glazet/QuadEVCharger/Schematics/S3pinout.pdf

Pin Name | Pin # | Used For | Pin Name | Pin # | Used For | PILOT_IN | ADC Pilot Read
1 | 4 | SW_IN (A) | 4 | 26 | PILOT_IN (C) | CT_IN | Current Transformer ADC Input
2 | 5 | SW_IN (B) | 5 | 27 | PILOT_IN (D) | PWM | PWM Generation Pin
42 | 6 | RL_OUT (A) | 6 | 28 | PILOT_IN (A) | RL_OUT | Relay Driver Pin
41 | 7 | RL_OUT (B) | 7 | 29 | PILOT_IN (B) | SW_IN | Switch Input
40 | 8 | RL_OUT (C) | 15 | 30 | CT_IN (A)
39 | 9 | RL_OUT (D) | 16 | 31 | CT_IN (B)
38 | 10 | NFC_MOSI | 17 | 32 | CT_IN (C)
37 | 11 | LCD_SDI | 18 | 33 | CT_IN (D)
36 | 12 | NFC_SCK | 8 | 34 | LCD_CS
35 | 13 | LCD_DC | 3 | 35
0 | 14 | GLED_OUT | 46 | 36 | PWM_C
45 | 15 | RLED_OUT | 9 | 37 | PWM_D
34 | 16 | PWM_B | 10 | 38 | NFC_SS
33 | 17 | PWM_A | 11 | 39 | LCD_RST
21 | 18 | | 12 | 40 | LCD_SCK
20 | 19 | SW_IN (C) | 13 | 41 | NFC_MISO
19 | 20 | SW_IN (D) | 14 | 42 | NFC_RST
