glazet/QuadEVCharger/(threads)

Thread 4 (2023-09-17):

Simple Product Description

neilh10, 2023-09-17:
Issue can be used as tracking items. I'm generating a few here to be tracked and discussed

What is a simple product description?. In keeping it simple, the exact words may be re-defined as there is more understanding of the potential customers

CalvinJDP, 2023-09-17:
Our team, Kilowatt Kings, is currently working on the design of a Smart Quad Electric Vehicle Charger. We have three primary objectives we aim to address. Our first objective is to address the new 2023 CalGreen requirement, which mandates one EV charger per four parking spaces. Our second objective is to efficiently provide charging for a 1:4 ratio of cars per charging station. Out third objective is to ensure that each car receives a charge sufficient for an estimated 30-mile commute, considering the average commute distance in California. Our approach to achieve these objectives involves designing a single-unit EV charger capable of accommodating four cars simultaneously. Each car will receive approximately 30 minutes of charge time before the system cycles to the next vehicle.

glazet, 2023-09-18:
An even more simple version:
Our team, the Kilowatt Kings, are designing an EV charger that can charge up to four vehicles from a single charging station and will meet upcoming CALGreen regulations. The charger will provide enough charge to the vehicle to make a 30-mile commute. When multiple vehicles are plugged in, the station will decide which vehicle gets charge and for how long.

Closed 2024-04-14.

Thread 5 (2023-09-17):

Who are Potential Customers

neilh10, 2023-09-17:
Issue can be used as tracking items. I'm generating a few here to be tracked and discussed

Neil:  Who are the potential customers - the people who specify it and/or buy it.

From Bab Solater's email 2023-09-16,
4.	Develop some understanding as to who may be potential customers and
the business models that are likely to be deployed, e.g.:

a.	End customers: Property owners/developers/property managers
b.	“Intermediate customers” eg. Design/Build Contractors

CalvinJDP, 2023-09-17:
Our potential customers would be property developers/contractors, property owners, businesses with parking facilities, and EV fleet owners.

glazet, 2023-09-17:
Also EV charger manufacturers could want a quad charger. I have only found dual chargers being sold. I'm not sure if EV manufacturers would be interested in a charger that isn't their proprietary model. After reading an NPR article on EV charger demand, city municipalities could want these chargers to install on the streets.

neilh10, 2023-09-18:
@CalvinJDP  good, needs maybe more flushing out.  At the core - potential customer are those who have 4 parking spaces that a consumer vehicle might plug into and be left for 4+ hours.  So multi-family overnight, workplace parking lots for daytime parking, Ferry Terminal parking, commuter park and ride, Then its the process who designs for these spaces and who owns them.

neilh10, 2023-09-18:
> Also EV charger manufacturers could want a quad charger. I have only found dual chargers being sold. I'm not sure if EV manufacturers would be interested in a charger that isn't their proprietary model. After reading an NPR article on EV charger demand, city municipalities could want these chargers to install on the streets.

@glazet  I think should track all the EV chargers you find https://github.com/glazet/QuadEVCharger/issues/9

Closed 2023-11-07.

Thread 6 (2023-09-18):

What questions should be asked of potential customers while researching Quad EV Chargee

neilh10, 2023-09-18:
Neil email : 3) and then what questions for potential customers when you meet with them.
Focused question on the potential customer pain more appropriate than the
engineering of tell us your specification for our product.

Bob Salter email : 5.      In my opinion your interview questions should be focused on
discovering pain points/wants/needs. The questions will likely be different
for each type of customer that you interview.

@glazet provided a brain storming first pass - can you filter them through the above lens and post here.

CalvinJDP, 2023-09-18:
We have revisited the interview questions, I have posted them below. We are actively adding questions as we learn more about EV chargers.

 1) Are you familiar with the new upcoming CalGreen requirements for EV chargers?
 2) When designing EVSE, do you have any environmental concerns such as
     weatherproofing or site development?
 3) What are your concerns, if any, about electrical infrastructure in a given complex?
 4) *Site Owner* Do you currently have the electrical infrastructure to install EV chargers?
5) How do you envision scaling up/adding EV charging infrastructure to accommodate the growth of EVs?
 6) What challenges do you encounter during peak charging hours?
 7) Have you experienced any issues or challenges with existing EV chargers that you would like addressed in a new design?
 8) What is your preferred charging station/charging connector type?
 9) Are you open to providing feedback during the charger development process?
10) What do you consider crucial to ensure that EV charging stations are accessible for residents and customers?
11) How much space do you typically have to integrate new EV charging stations? Do you have a lot of space to work with or not a lot?
12) *If they do not have EV charging stations*Are you considering whether to make your EV charging stations available to the public or restrict their use solely to your tenants?
13) Given the potential cost of upgrading and installing these stations, are you planning to offer usage for free, include their usage cost within the rent, or charge users directly for their use?

Closed 2023-11-07.

Thread 7 (2023-09-18):

What specifications

neilh10, 2023-09-18:
What specifications does an EV Charger need to meet.  Provide a link or reference to the specification - this is likely to become a marketing specification.

djangodemetri, 2023-09-21:
[NEC 625 (Page 25)](https://www.nrel.gov/docs/fy21osti/78085.pdf) specifies installation of EVSE,
     Circuit breakers sized for 125% of load (which would be 50A for us)
     8AWG for cable
     Length less than 25 feet
     No back-feeding from EV when grid loses power

[ISO 15118's Plug and Charge](https://en.wikipedia.org/wiki/ISO_15118) controls identification and authentication over IP

[IEC 61851-1](https://webstore.iec.ch/publication/33644) defines duty cycle values Control Pilot (CP)

[Open Charge Point Interface (OCPI)](https://www.ampcontrol.io/post/what-is-ocpi-and-why-is-it-important-for-ev-operators) allows cross company payment/charging

[Open Charge Point Protocol (OCPP)](https://en.wikipedia.org/wiki/Open_Charge_Point_Protocol) is protocol between EVSE and network

[IEC Mode 3](https://www.allaboutcircuits.com/technical-articles/four-ev-charging-modes-iec61851-standard/) means permanent cord set

[IC-CPD](https://www.aptiv.com/docs/default-source/user-manual/english-user-manual-ic-cpd.pdf?sfvrsn=acac163e_2) provides additional circuit breaker and ground monitoring

[NEMA 14-50R](https://calgreenenergyservices.com/2022/08/24/2022-calgreen-tier-1-and-2-ev-requirements/) is receptacle for EVSE

[HOA and EVSE Interactions](https://california.public.law/codes/ca_civ_code_section_4745)

Closed 2024-04-14.

Thread 8 (2023-09-18):

What functionality does the common control need to support

neilh10, 2023-09-18:
This is a tracking item to collect the internal engineering technical requirements for the common control.
This may map to items specified in https://github.com/glazet/QuadEVCharger/issues/7

For instance each charging port has technical specifications to detect a charging cable plugged in, and also through a 12V 1KHz PWM. Provide a technical reference for each specification

This is likely to feed into the decision on what small board computer to use, and inputs and outputs it needs to support, with custom hardware needed

glazet, 2023-09-21:
I have been looking into what microcontrollers we can use to output 4 PWM signals.  I have found a few:

ESP32 - Has 16 channels for configurable PWM signals. See page 36. ESP has a large community so resources should be manageable to find. Currently using ESP8266 in my IoT class, will soon develop comfortability with this chip.
chrome-extension://efaidnbmnnnibpcajpcglclefindmkaj/https://www.espressif.com/sites/default/files/documentation/esp32_datasheet_en.pdf

Arduino Mega 2560 Rev3 - This has 15 pins that can be used as a PWM channel. Its Arduino so heavy support as well.
chrome-extension://efaidnbmnnnibpcajpcglclefindmkaj/https://docs.arduino.cc/resources/datasheets/A000067-datasheet.pdf

PIC18F46K42 - A PIC microcontroller that Django and I are familiar with from our microcontrollers class. It has 4 PWM channels which is exactly what we need. I have 6 of these on me so they'll be cheap(free) and replaceable. See page 11 for PWM pin data.
chrome-extension://efaidnbmnnnibpcajpcglclefindmkaj/http://ww1.microchip.com/downloads/en/DeviceDoc/Microchip%208bit%20mcu%20%20PIC18%20L_F26_27_45_46_47_55_56_57K42%20low-power%20high-performance%20mcu%20with%20xlp%2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

RaspberyPi 3B+ or higher models - we could use the GPIO pins to output a PWM signal but takes some coding finesse. Could be useful for network connection. Easily access WiFi. May not be perfect for relay control.

djangodemetri, 2023-09-21:
[Manual with tolerances (PDF page 41)](https://hmr.araiindia.com/Control/AIS/210201752832PMAIS138_Part1.pdf)

Requirements:
1) 4 pins capable of generating PWM signals
2) 4 ADC pins with high enough resolution (maybe 10-bit minimum) and fast enough processing time (shouldn't be a problem in our application)
3) 4 pins for Proximity Pilot
4) 4 pins for triggering relays/contactor
5) Not necessary but for future proofing, should be compatible with either
     a) CAN bus
     b) Wi-Fi
     c) Bluetooth
6) Likely need watchdog capabilities
7) Power saving would be nice when no EVs are plugged in

neilh10, 2023-09-21:
> I have been looking into what microcontrollers we can use to output 4 PWM signals. I have found a few:

JUST an FYI, when looking at the processor, I would suggest you look at it as a SBC - Single Board Computer - integrated computer and circuitry with a connector.
List all the specs needed first in table format with a weighting. So program size, 4 PWM capable (may be seperate board, but be nice if onboard, likely to requires specialist interface circuitry), Connectivity/Wifi, USB ports (possible Screen interface),  should it support lunix, power used and of course cost.

There are many SBC lists out there, and once you learn a specific https://www.seeedstudio.com/blog/2019/11/20/best-single-board-computers-of-2019/
https://www.electromaker.io/blog/article/best-single-board-computers

Then you are looking for the 4 PWM support,   and then software that would support testing the hardware.
So just as navigator there is Raspberry Pi flavors, there is also Beagle Bone Green Wireless (that I like and have used)
There are some good reasons to go with a non-linux machine, like needing to be power conscious, but this doesn't apply with your power capability.
So you may be looking at types of linux to consider, from Raspberian, BeagleBone, Ubuntu
https://ubuntu.com/embedded
So my observations is this will knock out the small microcontrollers MEGA2560 PIC18F46K42
I would think the ESP32-S3 would make your list ~ and a SBC list . https://shop.m5stack.com/collections/m5-controllers
https://www.cnx-software.com/2021/07/18/linux-5-0-esp32-processor/

neilh10, 2023-11-06:
https://github.com/glazet/QuadEVCharger/discussions/18#discussioncomment-7484395 mentions prototyping with ESP32-S3 PWM as being a significant factor.
Seems like that maybe should be a separate **dependent** issue linked to this and #22.

Doing that you could  list the tools you are using and what the status is, ie not working

I've been looking closely at the ESP32-S3 and particularly its dual processor and co-processor RISC and the new variant ESP32-C6. The ESP32-S3 Looks to be nice choice for QuadEV, with allocation of the processors to specific current and future tasks.

There is a https://shop.m5stack.com/products/m5stack-cores3-esp32s3-lotdevelopment-kit with 2" screen that might fit with a QuadEV proto.

Earlier this year I purchased the M5Stack - Station https://shop.m5stack.com/products/m5stack-station-esp32-iot-development-kit-rs485-version for a trial which hasn't worked out. It has the dual core ESP32-D0WDQ6-V3, and I could loan that if its useful.

I've been using tools platformio.com  which is a productivity environment for Arduino Framework, and sits on top of VSC.
However it needs tweaking before the  standard Arduino builds. Happy to help with the learning curve
https://docs.m5stack.com/en/quick_start/cores3/arduino

neilh10, 2023-11-07:
Good to see the PWM working test on ESP- S3
See [com/products/m5stack-cores3-esp32s3-lotdevelopment-kit](https://shop.m5stack.com/products/m5stack-cores3-esp32s3-lotdevelopment-kit)

test software
https://github.com/m5stack/M5CoreS3

Closed 2024-04-14.

Thread 9 (2023-09-18):

List all EV charger products/manufactures

neilh10, 2023-09-18:
List the EV Chargers with a reference to the specification sheet - how many do they support

CalvinJDP, 2023-09-19:
Here is a lit of some EV Chargers specifically Level 2 chargers

- [ChargePoint](https://www.chargepoint.com/drivers/home/flex-promo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)
50 Amps, NEMA plug, Single Port Charger

- [Electrify America](https://www.electrifyhome.com/homestation)
40 amps, NEMA plug, Single Port Charger

- [Grizzl-E Duo](https://grizzl-e.com/product/usa/duo/grizzl-e-duo/)
40 amps, NEMA plug, Dual port Charger (Splits current)

- [REV+ Dual Port](https://www.rplusev.com/online-store/REV-Dual-Port-Level-2-Electric-Vehicle-Smart-Charger-50-Amps-WiFi-Bluetooth-UL-Listed-Mobile-App-Integration-p101982974)
50 Amps, J1772, Dual Port Charger

- [EvoCharge](https://evocharge.com/product/evocharge-40-amp-ievse-home/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)
40 Amps, J1772, Dual Charger

- [ClipperCreek](https://enphase.com/store/ev-chargers/residential-ev-chargers/clippercreek-hcs-d50r-dual-ev-charger-hardwired)
32 or 40 Amps, J1772, Dual Port Charger (Split current)

-[BOSCH](https://boschevsolutions.com/charging-stations/ev800-series-bollards)
32 amps, J1172, Dual  Port Charger

Closed 2023-11-07.

Thread 10 (2023-09-21):

Power Circuitry Considerations

djangodemetri, 2023-09-21:
[NEC 625 (Page 23)](https://www.nrel.gov/docs/fy21osti/78085.pdf) specifies no back-feeding when grid loses power

Do We Want to Use 220V or 48V or 24V?:
     1) Price
     2) Time
     3) Ease of testing
     4) How much does it matter that we parallel real world specifications?
     5) Whichever voltage we choose, how many amps do we want for daily testing?

Possible Actuators for Mains:
      1) Relay
           a) Mechanical or solid state?
           b) Is trigger voltage ac or dc?
           c) Is trigger voltage 5V or 24V or 48V? 5V reduces the need for amplification and reduction but also moves the product farther
           away from regulation
      2) Contactor
           a) same questions as 1)
      3) Thyristor
      4) TRIAC

How Long Does it Take to Switch Amperages?:
     Could this be found in J1772 documentation?
     Can our actuators match this required time?
     Does it even matter in this application? (relatively low performance application)

Surge Protection:
     Use of [MOV in parallel](https://electronics.stackexchange.com/questions/640162/how-do-movs-work-for-surge-protection) for surge protection
     Do we want to include this in our scope?

Ground Protection:
     Do we want to include this in our scope?

Stuck Relay Protection (if applicable):
     Do we want to include this in our scope?
     [EDM](https://www.motioncontroltips.com/what-is-external-device-monitoring-how-does-it-relate-to-machine-safety/) (external device monitoring) is a simple way to achieve this safety while avoiding additional software. It requires force-guided relays.

Thread 11 (2023-09-21):

Software Requirements/Considerations

djangodemetri, 2023-09-21:
1. General Requirements:
a) Needs to generate 1kHz PWM signals of duty cycles ranging from 10% to 66% [(Page 12)](https://www.fveaa.org/fb/J1772_386.pdf) and 100% (I think for 12V idle state which has no frequency [(Page 11)](https://www.fveaa.org/fb/J1772_386.pdf))
    a.1) Needs to switch duty cycles depending on how many EVs are plugged in
b) Needs to notice amplitude changes in control pilot
    b.1) Needs to recognize [6 voltage levels](https://en.wikipedia.org/wiki/SAE_J1772#Control_Pilot) (12V, 9V, 6V, 3V, 0V, and -12V, or more correctly, 6 voltage levels from 3.3V to -3.3V)
c) Needs to output ac or dc to actuators
    c.1) Depending on choice of actuators, timing may be crucial. Solid state relays for example
d) Needs to recognize voltage in proximity pilot circuit [(Page 14 Through 16)](https://www.fveaa.org/fb/J1772_386.pdf)
    d.1) Reveals what [current rating for cable](https://en.wikipedia.org/wiki/SAE_J1772#Proximity_Pilot)
    d.2) Does not allow actuators to be activated until 1.5V is generated [(Page 14)](https://www.fveaa.org/fb/J1772_386.pdf)
e) Needs to receive input from current sensors and record values for billing purposes
    e.1) Needs sufficient permanent storage
f) Possibly code for power savings, (likely will be copy and paste)
g) Watchdog code if software gets stuck (defined by pointer movement specifically)

2. Runtime Duration:
a) Structure the software so it can aptly react to EV input, (should be pretty easy, performance is not too important)
a.1) If solid state relays are used and shutting them off at the wave node is important, this criterion becomes incredibly important

3. Power Allocation Schema:
a) Takes user input about battery life and/or expected time of charger use. No input at all is also accepted.
a.1) Write a formula that relates battery life to time that switching device is on.

4. User Interface:
 a) Informs user of how many plugs are in use
 b) Allows user to input parameters like battery life and/or expected time of charger use. This should be touch screen.
 c) Has alarm state that notifies the user that the charge is inaccessible

 5. (Possibly) LED that indicates alarm state:
 a) Visible from a driving distance so that cars know the charger is non-functional before pulling into the spot. Remember, a lot of EV have their charge port in the back and a lot of drivers are really bad at reverse parking.

 6. Charging algorithms:
 a) One at 208V 40A (Residential setting)
 b) One at 220V 40A (Commercial setting)
 c) The user inputs their battery level and the algorithm incorporates that. User could also input their vehicle size so we could use their battery capacity in the calculations as well. Time of day might be another parameter.
 d) The manuals have a simple formula for calculating duty cycle from number of amps desired. We should create simple formulas as well
 e) If the user doesn't specify then there is a default charging schema, and likely they are a lower priority since they didn't bother to specify anything
 f) Ideas to start:
 f.1) Find out how much power is given to a battery in 10 minutes. That will give some scale.
 f.2) Gather a list of what batteries are on the market and their capacities. [Here is a list of batteries](https://ev-database.org/imp/cheatsheet/useable-battery-capacity-electric-car) (Smart car-16.5KWh, Hummer-246KWh, Model 3-50 to 82KWh

Closed 2024-04-14.

Thread 19 (2023-10-23):

ADC Testing and Verification

glazet, 2023-10-23:
Here is the issue tab for discussing testing our ADC, verifying its accuracy, and understanding how to integrate it within our system. We will post results from these tests as we complete them.

Thread 21 (2023-10-23):

Proximity Pilot

glazet, 2023-10-23:
The first connection with the EV and EVSSE, this is a crucial step in our project. Here we can discuss how to build and implement the proximity pilot circuit and effectively utilize its status.

neilh10, 2023-10-23:
Can you describe the Proximity Pilot in terms of the specification. Circuit diagram etc can be posted. Any precursor (like ADC) can be listed.  The Labels - can be set to enhancement, the Assigneess to team member is working on it.

glazet, 2023-10-26:
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
^Info on PP voltage states

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
^Calculations for Proximity pilot voltages

neilh10, 2023-10-26:
Good to see the how the cable carrying capacity is defined.
Its built into the J1772 Plug as part of its handle with the switch - when the switch on the top of the handle is pressed it tells the vehicle to stop taking a charge.
From what I've seen, the vehicle then has a mechanical latch, that unlocks the plug , and the plug can then be manually removed.
As per the email - Oct 24 - seems to me since the  Proximiy Pilot circuitry is located in the cable head "EVSE Connector" - its purchased in as part of the J1772 cable, and I don't believe your hardware verification goes to having a vehicle present  - it doesn't need to be designed. Magic - best type of circuitry - part of an item purchased in.

Thread 22 (2023-10-23):

Control Pilot hub

glazet, 2023-10-23:
Here we can discuss how we will construct our +/- 12V 1kHz square wave that is within +/-4Hz accuracy.  We must be able to have this signal reliably reach each of the 4 EVs.

neilh10, 2023-10-25:
To be accurate, each EV cable requires a CP generator, under the control of the processor
From https://en.wikipedia.org/wiki/SAE_J1772 - references SAE J1772-2017 standard , and a general circuit. There maybe a more authorative reference, but this is the general requirement
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

glazet, 2023-10-26:
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
^Control Pilot states and their voltages

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
^Effect of duty cycle on amp level

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
^Example signal

Source: [https://www.fveaa.org/fb/J1772_386.pdf]

neilh10, 2023-11-06:
https://github.com/glazet/QuadEVCharger/discussions/18#discussioncomment-7484395 mentioned CP verification with simulation. I wonder could this be updated to reflect work done and data collected?

neilh10, 2023-11-13:
In https://github.com/glazet/QuadEVCharger/discussions/18#discussioncomment-7558644 issues where mentioned with the Op-amp  but no values are given.
Please identify the op-amp you used and the test circuit in this issue report.

2nd request - please publish the circuit you are using for CP and simulation values.
Using LTspice for the simulation is FANTASTIC !!!, It provide the opportunity to make real technical comments.
  Its probably a good idea to maintain the same output impedance (sum of the resistors) with the shift to 3.3V.
The resistors need to be taken from a series that is purchasable and have a defined tolerance - probably 0.1% in this case as its creating a measurable threshold, but maybe 1.0%,if you can't find a low cost 0.1%.  Probably E96 or E192  https://en.wikipedia.org/wiki/E_series_of_preferred_numbers

The effect of what happens when the vehicles charging circuit activates should also be included in the simulation.
For a comprehensive simulation it would also be useful to simulate the tolerance on the voltage lines +12V and -12V and +3.3V.  These should be possible to fit into the simulation
https://courses.engr.illinois.edu/ece343/sp2021/tutorial/ltspice_tut.pdf  - possibly "Monte Carlo "

These are all needed to determine what are the DC ranges that the ADC needs to read, and is the ADC Vref stable and accurate enough for reading these ranges.
https://github.com/glazet/QuadEVCharger/issues/19

neilh10, 2023-11-14:
Great to hear and that you are getting real world issues. Thats the puzzle.
The ADA4610 is a "family" so you  need to order a specific device and you want it to meet outdoor temperature?
https://www.analog.com/media/en/technical-documentation/data-sheets/ADA4610-1_4610-2_4610-4.pdf
It looks to me there isn't a DIP version.
How are you planning to breadboard the specific device ordered? is it DIP or SOIC.

quad OpAmps  are very plentiful - and need the higher voltage of +24V but low slew rate - simulations are all similar for this type of frequency
From Digikey I count 236  https://www.digikey.com/en/products/filter/instrumentation-op-amps-buffer-amps/687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
Though there are 19 that are a DIP package often useful in prototyping on a bread board, and even smaller number that are outdoor range.

Possibly the LT1491CN is an analog device (maybe has a simulator) and comes in 14PIN DIP for breadboarding - though still on the expensive side if this was a real product.
https://www.analog.com/media/en/technical-documentation/data-sheets/14901fb.pdf
[LT1491CN#PBF](https://www.digikey.com/en/products/detail/analog-devices-inc/LT1491CN-PBF/1620006)

For your problem there isn't enough detail  - " no voltage reading at ADC-Vref" - measured by what ? Voltmeter or internal ADC.   Be good to snip the circuit and post it. :)

neilh10, 2023-12-03:
How about this analysis of the CP circuit - could it be discussed at the next meeting
[QuadEV_CP_RRR_divider - 5V.xlsx](https://github.com/glazet/QuadEVCharger/files/13539770/QuadEV_CP_RRR_divider.-.5V.xlsx)

djangodemetri, 2024-02-23:
Part 1 is an initial look at the circuit. Part 2 is the simplification using the assumptions made on the right.

I'm not sure my handwriting is legible so I'm going to transcribe what I wrote here:
"But the comparator saturates and does not display a typical IV curve. So we can approximate it as a independent voltage source and internal resistance. Also Rin of the op-amp is almost infinitely large so the rest of the circuit is isolated.

![Uploading IMG_20240223_152923773.jpg…]()

neilh10, 2024-02-23:
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

So assuming you want to have the ADC swing between 3.3V and close to 0V  (though actually it maybe that the input range when calibrated is actually 2.8V?)

The values you have posted of 140K 66K 40K  with 3.3V pullup for the +12V to 12V,   I get a swing of 3.521V to 0.018V   - so upper end out of range.

Now should be noted the 66K and 40K don't exist as real resistors - the E96 series lists 66.5K and and 40.2K

https://www.vishay.com/docs/28372/e-series.pdf

The standard values of 200K+100K - 300K total impedance you probably don't want to change - ie you have 140 + 66=206K has dropped the interface loading  by 1/3

For some values I tweaked - I got a swing

218K  81.6K 58.3K  for +12V to -12V I get a swing of 3.284V and 0.041V     ~ and impedance is 218+81.6 299.6K - close to the original 300K

[QuadEV_CP_RRR_divider.xlsx](https://github.com/glazet/QuadEVCharger/files/14390893/QuadEV_CP_RRR_divider.xlsx)

I could only find a device OPA4227 for quad opamp
Looking at the circuit
https://www.fveaa.org/fb/J1772_386.pdf
the Diode is a clamping diode preventing a negative swing, not a rectifying in series diode.

neilh10, 2024-02-24:
The original reference circuit is Pg 36 on https://www.fveaa.org/fb/J1772_386.pdf
Correction : the diode shown is a clamping TVS diode, "22.5V Clamp 27.1A Ipp Tvs"
https://www.digikey.com/en/products/detail/littelfuse-inc/P6SMB16A/1766582
 probably to protect the Op-amp from any spikes on the PILOT  cable that goes out to the vehicle.

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

CalvinJDP, 2024-02-27:
Currently in our schematic we have a rectifier circuit between the S3 and the resistor network. If we use your suggested resistor values does that mean we do not need the rectifier circuit?
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

neilh10, 2024-02-27:
yes. If you already have the PCB, it can just be shorted.
The interesting part of what the resistor network is doing -  level shifting it to be in range of the processors.
The original circuit was 0-5V - and using the spreadsheet I created a thevinens equivalent circuit with the resistors - and it shifts between . Now its 0-3.3V
Initially when I saw it, I thought how is it coping with going negative.
Turns out with the original resistors ~
see QuadEV_CP_RRR_divider - 5V.xlsx
Change cell E25 for +12 and then -12 - and read off E56
+12V in resulted in +4.543V at PilotRead , and
-12V resulted in  0.891V at PilotRead

Then change the resistor values and Vcc=3.3V in
QuadEV_CP_RRR_divider.xlsx
I went over with @djangodemetri on Saturday.

neilh10, 2024-04-11:
Good to see the full schematic V3 on - https://github.com/glazet/QuadEVCharger/tree/main/Schematics
 One circuit "J1772 negotiation", could be good to highlight how you verification tested
with all the electronic parts and values the team decided on is the path of the PWM.  Explaining the function of the 5 resistors - 4 on the board below, and one on the EV - R19 current limit, R17/R16 voltage divider, R18 bias resistor.
Why PWM swings of up to +12V to -12V from OPA1 driven by the processor , are seen as 0-3.3V at the ADC,  and what values you calculate in the 0-3.3V range and what values you actually measured for circuit verification

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

Thread 23 (2023-10-23):

Decision Algorithm for EVSE

glazet, 2023-10-23:
Here we can discuss how the algorithm will decide who gets charging and when they receive it. Utilizing user inputs would allow us to make better educated decisions on who should get charging. Keeping in mind that the issue we are aiming to solve is long term parking, so those who need charge and will remain in their spot for 4+ hours.

neilh10, 2023-10-31:
I would suggest this be broken into a number of sections. a) controlling the hardware EVSE CHARGE PILOT - Advertising current available,  (ADC level input and PWM Duty Cyclable)   implemented as a "Firmware Driver"  b) the User Interface  c) the billing output?  d) ?
etc. For
The file https://github.com/glazet/QuadEVCharger/blob/main/Algorithm.py probably belongs to this section.
For a) Can this be described in terms of  Driving the PWM https://github.com/glazet/QuadEVCharger/issues/22#issuecomment-1781831137 - Pseudo Code in the file could be used.
[Possibly https://www.fveaa.org/fb/J1772_386.pdf Pg13 expected PWM levels   Pg 36 circuit interfaces)

neilh10, 2023-11-03:
The OpenEVSE is quite a find. It implements a full algorithm on the AVR processor and the code is available for looking at https://github.com/OpenEVSE/open_evse/tree/master/firmware/open_evse.
Notice the https://github.com/OpenEVSE/open_evse/tree/master  platoformio.ini - indicating it uses the platformio.org build environment. I've been very pleased with it myself.

Thread 24 (2023-10-31):

Switching Devices Hub

glazet, 2023-10-31:
Here we can discuss our switching device and its control parameters.

glazet, 2023-10-31:
Here is the current contender for our switching device. The [Packard C240C](https://store.openevse.com/collections/all-products/products/packard-c240c-40a-contactor-208-240vac-coil-50-60hz) is a 208/240VAC contactor with two poles. It requires 12VDC to activate the switch. It can handle 40A inductive and 50A resistive. Along with its cheap price per unit(~$11), it has been used by other EVSE projects and works wonderfully. Only concern is that I have not been able to find a datasheet but I have contacted Packard themselves and have requested one. Other relays I have found either don't have a 50A max capacity or are too expensive to justify buying($108 per unit).

glazet, 2023-11-14:
We have finally found and ordered our relay we will use. The STRUTHERS-DUNN 450XBX50-12VDC will be able to meet our design parameters of 240VAC 50A switching requirements and takes 12-VDC to open and close the poles. We only ordered one right now to be used for testing. Our initial tests will be opening and closing the poles using the ESP32. This will require a driving circuit, which is provided on the OpenEVSE PowerPoint. We have the correct transitors needed for the driving circuit so its just a matter of when things get delivered. I can begin with a simulation of the driver circuit on LTspice.

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
^Image of the relay driver circuit diagram

glazet, 2023-11-14:
My question for @neilh10 is what is the JB1 component in this diagram. My assumption is that is the relay itself but as a SPST version, but I'm not 100% sure. I have not seen that component symbol before.

neilh10, 2023-11-14:
@glazet - did you mean  JP1 - probably the socket for the relay of the original circuit. Its a typical connector symbol - 3pin. May be different for the 450XBX50-12VDC
My guess for the picture/cct shown its the relay driver. The relays look like they have a spade connection for the 50A path.

https://relays.struthers-dunn.com/item/power-relays/450-series-cross-reference/450xbx50-12vdc
Seems like for safety you would want the Cover or  450XBX50C-12VDC
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
You might want to have the LED that indicates its on. Do you have an application not for the relay - I can't see how the wires connect to it, seems like it is a socket.
These heavy duty relays are challenging, though there must be a version that is in all the different EV chargers out there

Thread 25 (2023-11-02):

Current Division or Time Division?

djangodemetri, 2023-11-02:
Facts:
Minimum of 8A for Rivians

Assumptions:
Cars will take the majority of power if allowed

Current Division:
Pros:
More effective usage of current and charge points
Immediate charge
Less heat (H=kI^2)

Cons:
Complex
Expensive
Small charge per vehicle
Battery getting to charging temperature

Time Division:
Pros:
Simpler
Cheaper
Better battery charging curve (assumption)

Cons:
No immediate charge
Not using ports or amperage fully
More heat

Future:
Download apps to test minimum amperage
What is the minimum temperature for the battery to charge?

neilh10, 2023-11-03:
Gosh from reading this, what is the  technical question you are phrasing? and trying to track.
The customer issue is plugging in and getting charge till battery full, with up to 4 vehicles charging, and getting it in the shortest period possible.
The technical optimization is to use the 40A from the EVSE/grid as fully as possible.  The J1772 protocol "Charge Point" language is that the PWM signal advertises the current the vehicle can take, however the vehicle takes the charge it can handle up to the advertised limit, OR up to when its battery is fully charged.  My understanding is that generally batteries are better on a slower charge so the vehicles may not take all the charge if they are offered it.
To me optimally "sharing the current" on up to 4 vehicles taking a charge, is likely to lead to all vehicles getting a full charge in the shorted period. The optimally sharing the current means it requires to monitor the actual current that is being drawn. A smart algorithm is one that can detect what the vehicle is taking, and change the PWM to what is being "advertised" across the plugged in vehicles, however that is software and maybe too complicated.
Other options could be considered for "marketing" purposes, including variable electricity rates,  and that would seem to be beyond just proving the hardware at this point.
Can you re-phrase this to be clear about what your technical issues is.
If your issue is that you can only implement one current sensor for ....., then its better to state the reason, and then technically how the system still works.

Closed 2023-11-07.

Thread 26 (2023-11-13):

Plausibility of Engineering Requirements

djangodemetri, 2023-11-13:
ER 3: Must be capable of switching current nominally at 208VAC
1. We need door access to the room with plug
2. Find wire that can handle 208VAC (not hard)
3. Double check that we have equipment that can read 208VAC. If not, we need to step the voltage down

ER4: Must be capable of switching current nominally at 25A
1. Find a device that can measure 25A. If one is not available, maybe create a current divider and measure each branch separately (4 equal resistors, each having 6.25A?)
2. Calculate how much power each resistor would have and buy resistors that would rated at that power. (6.25A*5V=31.25W?)
3. Make sure the power supplies can actually reach 25A. Otherwise, change the ER to the maximum amperage the power supply can handle

ER7: Must be able to visually signal an alarm state that is visible within 10ft, line of sight.
1. How do we actually test this?

ER8: Must satisfy IEEE 802.11b/g/n
1. Research exactly what is required to satisfy these requirements.
2. Do we have the equipment needed to measure this?

ER9: NFC device must satisfy ISO 10373-6 (or can read 95%)
1. Likely we will not be able to find ISO 10373-6 so, in reference to Neil's troubles with his card not scanning, we could perform a reliability test. Can it successfully read data 95% over 50 scans?

neilh10, 2023-11-13:
TO me this is WAY too many technical issues for ONE tracking item.
The purpose of a tracking item is to be able to IDENTIFY a problem you need to track,  come up with SOLUTIONS and then IMPLMENT them.
The life cycle of the issue, is to initiate the item, allocate an owner at various stages, for that owner to find solutions, and or pass to another person in the team, before a team member implements the SOLUTION and closes it.

I would recommend you  create separate items for each of these technical issues, and then allocate owners, OR assign to yourself.

djangodemetri, 2023-11-14:
An issue for each question or an issue for every engineering requirement, (consisting of multiple questions)?

neilh10, 2024-04-11:
Is this still useful for the project?

Closed 2024-04-14.

Thread 27 (2023-11-14):

Engineering Requirement 3 Plausibility (Neil, I ran out of time, I will continue this soon)

djangodemetri, 2023-11-14:
ER3: Must be capable of switching current nominally at 208VAC

Problems:
We need to make sure we can actually achieve this engineering requirement
1. We need door access to the room with plug (not time pertinent)
2. Find wire that can handle 208VAC (not hard). This needs to consider amperage as well. (not time pertinent)
3. Double check that we have equipment that can read 208VAC. If not, we need to step the voltage down. (pertinent)

Solutions:
1. Door access is easy but needs to be listed
2. AWG is the United States standard for wire sizing. There are charts for all of these specs.
3. Do any professors/Shahram have devices that can read 208VAC? If not, we need to consider alternatives, (voltage devices)

Implementation:
3. Actually test this. Does it work? If it doesn't work, are you confident the solution can be found or are you guessing?

Future:
Think of anymore roadblocks, **THE IMPORTANCE OF THIS CANNOT BE OVERSTATED**

neilh10, 2023-11-15:
@djangodemetri  - you are getting way too complicated, and lacking focus on the engineering challenge.

Ask Shahram if he has approx 208 (possibly 220) VAC on a socket that you can plug in the system to test its "control function"

Specify all wires to be at a higher voltage.

My suggestion is that you do this as the very LAST test.
If it doesn't work and you blow up something as its not specified correctly it won't block other tests

Closed 2024-04-14.

Thread 28 (2024-02-16):

Current Sensing

djangodemetri, 2024-02-16:
This will consist of two parts: first, what I have done and second the questions I have.

Part 1: Progress?

Here is the circuit for the current transformer:
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

R1 is a burden resistor, which loads the CT and provides it a specific accuracy, per the datasheet. D1 and C1 make a simple passive rectifier. R2 and R3 will be a voltage divider because the CT outputs 5V when reading 50A. The values for R2 and R3 are yet to be found because a potentiometer was being used. (Yes, this may also change the value of C1 when R2 and R3 are picked)

The burden resistor was calculated using the equation, (which was found [here](https://electronics.stackexchange.com/questions/124386/calculating-a-burden-resistor-for-a-current-transformer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,the%20burden%20resistance%2C%20in%20ohms.)):
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
I realize now that the [datasheet](https://amgistoroids.com/wp-content/uploads/2020/03/CT1050.pdf) has values:
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
The intersection for approximately 5V and 10A through 50A seems to given a burden resistor value of around 100 ohm to 200 ohm. Whoops.

The voltage divider was set up as a potentiometer. I decided I would design around the maximum value. I generated 5V dc at the burden resistor, (since 5V is the maximum value the current transformer will produce), and adjusted the potentiometer until voltage across R3 was 3.3V.

Now that the circuit was built, it was time to test it. Sadly, the only ac power source that is available has a limit of 10A. I assumed the relationship between the CT voltage and the ADC voltage would be linear, so if I could plot points between 0A and 10A, I could extrapolate the entire relationship between ADC voltage and CT amperage.
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
This would mean that for every 1V at the CT, the CT would be reading 10A. If I corresponded each experimental ADC voltage value to a theoretical A value, I could obtain a constant and simply scale the reading the in the code. (This by no means is the most accurate but it's a starting point). But as you can see, it is not a linear relationship.

Part 2: Questions

I have at least two tolerances that I need to figure out. As seen the [datasheet](https://amgistoroids.com/wp-content/uploads/2020/03/CT1050.pdf), the lower the burden resistor, (or I assume it's the burden resistor), the less percent error we have. Secondly, we have the error in the ADC. The ESP32 has a 12 bit ADC which gives us a resolution of .8mV [step = (3.3-0)/2^12]. These tolerances stack so do we just add them?

How do I find the constant that I will multiply the ADC value by to convert it to current? How will I find this if the power supply can only achieve 10A and this relationship is not linear, (so it cannot be extrapolated)?

neilh10, 2024-02-16:
Hi Django   nice write up.  Really fantastic to see the circuit explained and look for a low cost way of measuring current

Great to see the calculations fleshed out - really need to do that for this type of circuit.

Seems to me there are four areas of error that still need to be investigated - the joy / challenge of analog circuitry :)   this is often why analog circuitry takes a lot of time to fine tune.  Sometimes can be monticarlo simulated for ranges of errors, but not all errors are built into simulators.

1) ADC Vref error 2) Load Resistor accuracy error 3) load resistor Temperature Coefficient error 4) Diode + R1/R2  accuracy

4) Looking at his first - R1/R2 could be eliminated by using the internal attenuator/divider - see ESP32-S3 .
Possibly provide a 3V3 clamp & R/C .
The C1 is better being close to the ESP32-S3 ADC pin, and a series R to the load resiator can then protect some spike protection with C1 and not affect the accuracy of measurement.
D1 is "text book", but a real problem for an accurate ADC - as the turn ON is likely to be 0.6V, and that means it can't measure the last 0.6V of voltage from the loading resistor. Lots of discussion about this - and possibly use germanium diode -the problem is having a calibrated turn-on - and its oscilating at 60Hz.
Another option might be to run the ADC faster than 60Hz, eg at 6Khz and look for the peak measure voltage over 8.3mS  1/(60*2) =. Then rely on the same  clamping diode to prevent the ADC_INPUT going negative and clamp spikes on loading resistor going above 3.3V.

These sources of error affect large volume production - so they may not impact single unit prototypes, except for the first error- but are good to understand.

1) The ADC Vref Error - From the ESP32S3 Technical manual 39.3.5
Vdata =  Vref/4095  × Adc_Value
https://www.espressif.com/sites/default/files/documentation/esp32-s3_technical_reference_manual_en.pd
elsewhere - it references the Vref as nominally 1.1V ~ though need to find a reference for its accuracy
Some clues https://docs.espressif.com/projects/esp-idf/en/v4.4/esp32s3/api-reference/peripherals/adc.html
I found "  however the true reference voltage can range from 1000 mV to 1200 mV"
that is the Vref is nominally 1.1V with a +/ accuracy of 0.1V  ~ or about +/-9%
and it suggests a way of calibrating the ADC - that is determine what the actual value is on this specific chip,
This would need to be calibrated per chip probably with an external meter of known accuracy
And that becomes the Vref_error.  If the external meter was +/1mV then the Vref_error=+/-1mV
Then that would need to be used in the above "Vref"
It seems the ADC subsystem can then attenuate that input voltage to allow stepped voltages.
See https://docs.espressif.com/projects/esp-idf/en/v4.4/esp32s3/api-reference/peripherals/adc.html#adc-attenuation
However if the actual Vref=1.0V then the highest voltage measurable would be 2.818V = 1.0/1.1 * 3.1V

So for the loading circuit, you don't want an input voltage to go above 2.8V as otherwise for some ESP32-S3 it might become non-linear.
From the CT1050 loading graphs above eyeballing it seems like 40A would produce 2.0V and 50A closer to 2.5V - so a good item to calculate.

2)  The loading resistor has an error - manufactured to a tolerance - its probably easy to go from 0.1% to 0.05% and possibly to  0.01% resistor and low thermal drift. Its low wattage as the max voltage on it is only likely to be 2.5V

3) Since this outdoor temperature range the load resistor - and other components will have temperature errors - or manufacturer characterizes it as a maximum "Temperature Coefficient". So a low temperature drift resistor is Metal Foil and Thin Film. Metal Foil is way more accurate and costly - probably used in space or aero space applications.
That is they have a value at -10C and then resistance changes as  the temperature increases to +70C.
For an accurate 0.01% at 49.9ohms at [Digikey](https://www.digikey.com/en/products/filter/chip-resistor-surface-mount/52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) (as they are the lowest cost ) the +/- 5ppm/C is $1.91
for a +/- 2ppm/C the cost doubles to $2.80 and there is even a lower+/ 0.2ppm - check out its cost.

Also started here https://github.com/glazet/QuadEVCharger/issues/20

neilh10, 2024-02-16:
analodRead() maybe pre-calibrated according to - https://esp32.com/viewtopic.php?t=34706, then just need to figure out what the error is.

Thread 29 (2024-02-23):

Porting ILI9341 display from ESP32-WROOM-32D to ESP32-S3

glazet, 2024-02-23:
There are some roadblocks to porting the current GUI setup from the EP32-WROOM-32D to the S3. The GUI was initially designed on the WROOM32D because of an abundance of support online in connecting it to the ILI9341 display. Documentation on S3 to ILI9341 is sparse and not very detailed.

glazet, 2024-02-23:
I am currently having issues even getting a simple demo to appear on the display. When I built the GUI on the WROOM32D I had to only uncomment lines 212-217 in the User_Setup.h file in the TFT_eSPI arduino library and connect the display to the corresponding pins.
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

I have tried to change the pin numbers in the User_Setup.h to match those I desired on the S3. They were as follows:
CS     GPIO3
RST   GPIO46
DC    GPIO9
SDI   GPIO11
SCK  GPIO12

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

I have also tried assigning the pins in the main program code as shown below but this too did not get any results.
#include <SPI.h>

// Define GPIO pin numbers
#define MOSI_PIN 11  // Replace with your desired MOSI GPIO pin
#define SCLK_PIN 12  // Replace with your desired SCLK GPIO pin
#define CS_PIN   3  // Replace with your desired CS GPIO pin

void setup() {
  // Start SPI communication
  SPI.begin();

  // Configure GPIO pins for SPI
  pinMode(MOSI_PIN, OUTPUT);
  pinMode(SCLK_PIN, OUTPUT);
  pinMode(CS_PIN, OUTPUT);

  // Set initial state for CS pin
  digitalWrite(CS_PIN, HIGH);  // Make sure the device is initially not selected
}

Anyone have any ideas on what I could be missing here? Any help is appreciated.

glazet, 2024-02-24:
[Here](https://youtu.be/pYp1Nxmfdeg?si=VpHWhF6YtDlEoi5G) is the link to the resource used to setup the ILI9341 with the WROOM32D initially.
[Here](https://youtu.be/6FsFwa304qc?si=bUcBk8F3_7bl08zt) is a video I found that could potentially help with the S3 setup, although I've ran out of time today to try it out. Will try this when I'm free Sunday(2/25/24).

neilh10, 2024-02-24:
@glazet - gosh challenging it just doesn't work. Though that often happens.
What I do is try and find a basic example of something that does work, and then do little steps.
I would guess at it being the base S3 SPI driver setup - either in your wiring or in the low level software.
See if you can verify a simple program to get some status from ILI9341 ~ little steps to start with .

neilh10, 2024-02-25:
@glazet taking a quick peak at this ~ I guess I'm wondering about your expectation on mapping.

Shouldn't it also be declaring a MISO?

1) Where did you get the board from,
2) what tools are you using?
For instance I use PlatformIO/VSC  and with the project wizard I can select a new board "Espressif ESP32-S3-DevkitC-1-N8(8 MB QD, no PSRAM)
and Arduino Framework
And then it initializes and brings in the setup.

C:\Users\<user>\.platformio\platforms\espressif32\boards\esp32-s3-devkitc-1.json

and in platformio.ini
[env:esp32-s3-devkitc-1]
platform = espressif32
board = esp32-s3-devkitc-1
framework = arduino

glazet, 2024-02-26:
@neilh10 - I have been taking the approach you suggested, the TFT_eSPI library has plenty of examples I've used to test the screen with. Sadly, I have been unsuccessful in getting any of these examples to work on the S3 but they easily run on the WROOM32.

As for the not declaring MISO, I had never declared it on the WROOM32 and was able to get the display to work perfectly, as you've seen in person. I believe that the MISO would be used if we were using the touchscreen feature but we are not implementing that function.

I am using the Arduino IDE to code the S3, as I was not able to find board support for my ESP32-S3-DevKitC1-N16R8 on PlatformIO. I have made sure that the S3 is even getting programs loaded onto it by running Calvin's WIFI test and I do get results back. So I know the board manager works and the S3 can run programs. I believe my issue is in the header file for the TFT_eSPI library. I will take a deeper look tonight and see what I can do to get this working.

glazet, 2024-02-26:
I have successfully gotten a demo to work on the display with the S3. Human error was at fault. I will start rewiring the prototype to work with the S3.

neilh10, 2024-02-26:
@glazet hurrah!.  I do think you want to capture what works with a github repo.

Closed 2024-02-26.
