glazet/QuadEVCharger/Schematics/SmartQuadEVChargerV3.pdf

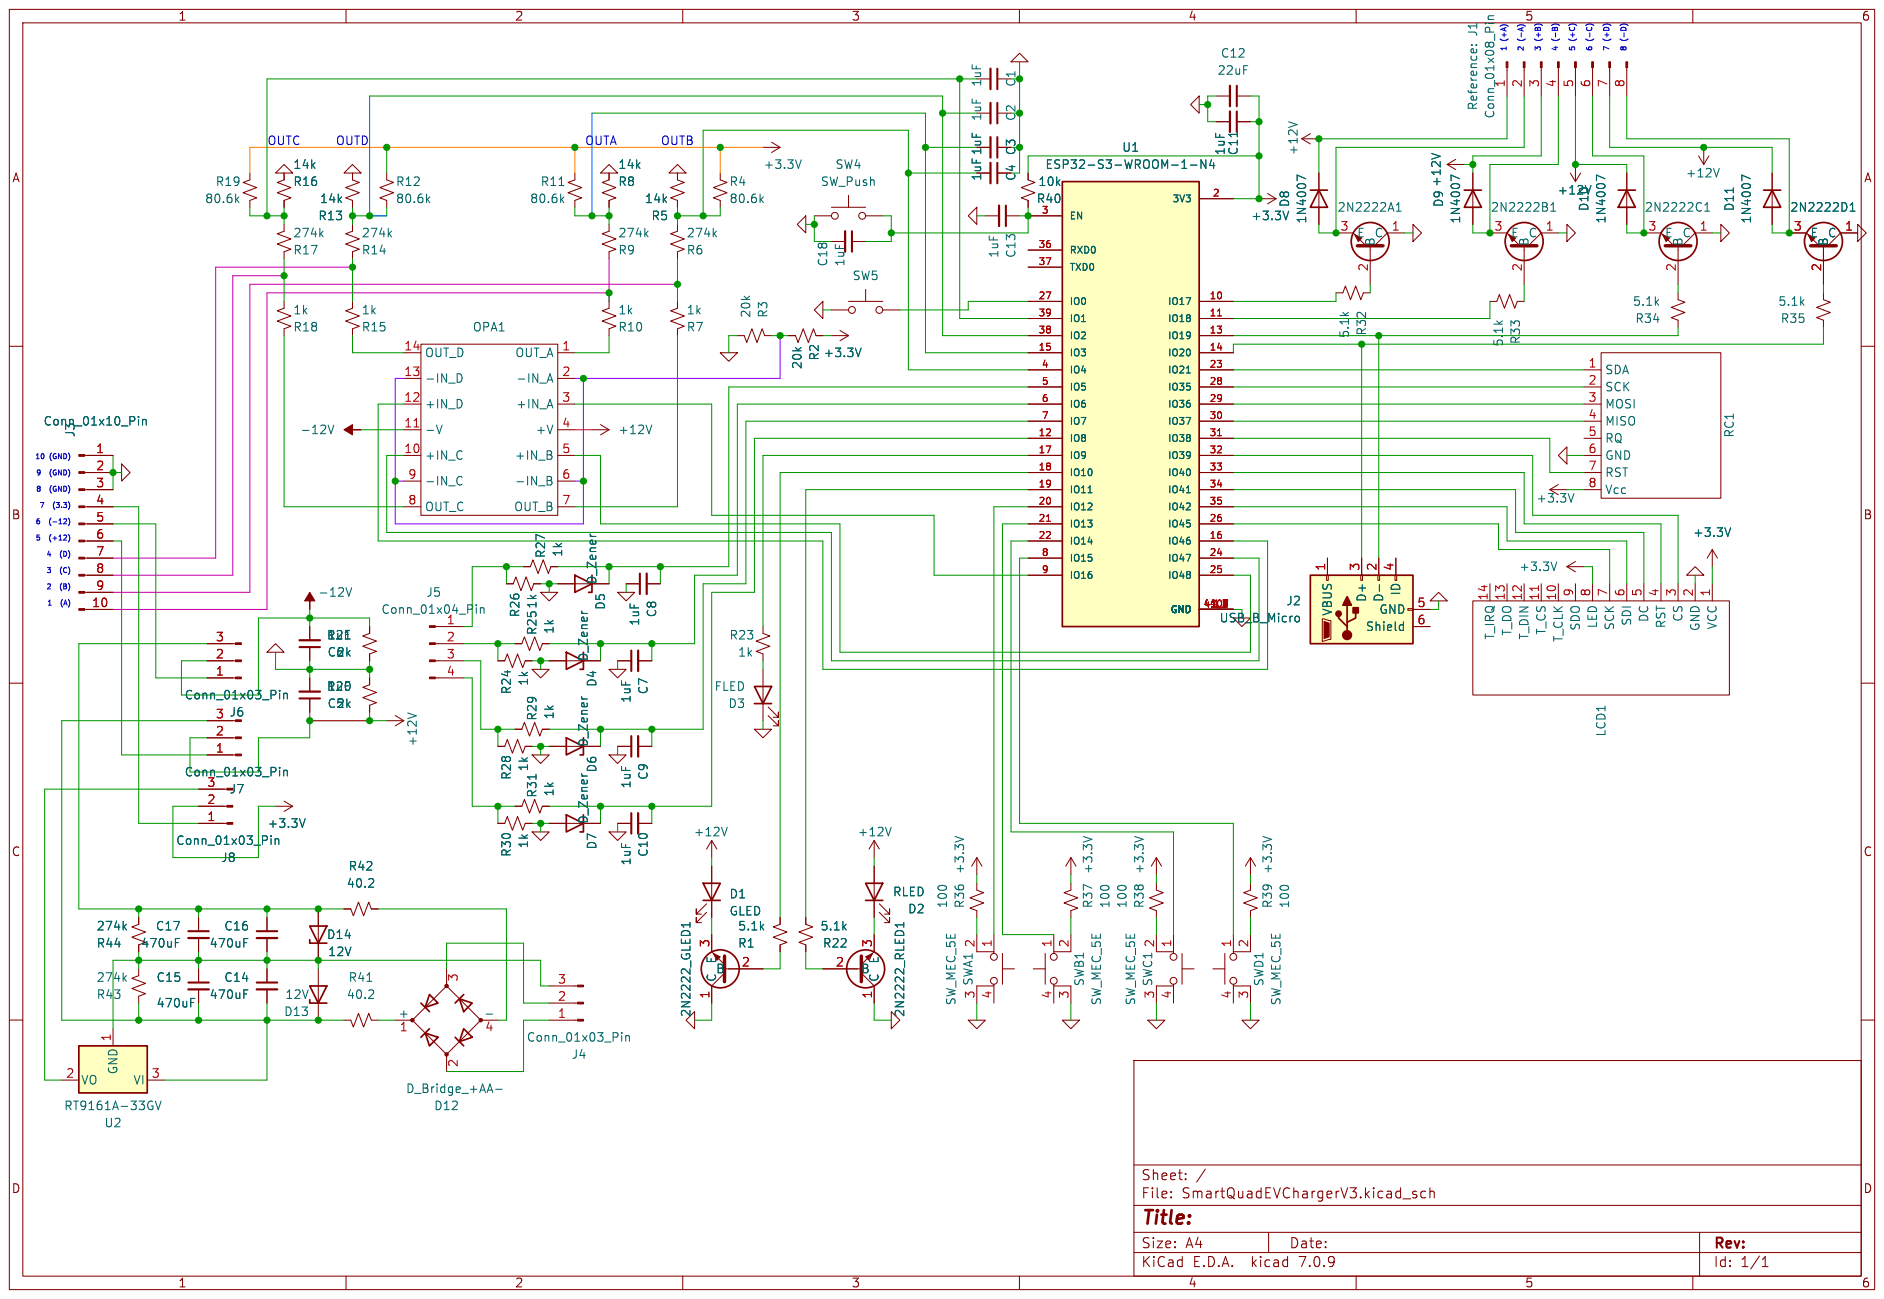
[picture p1: page 1]
