glazet/QuadEVCharger/Schematics/SmartQuadEVChargerV2_2.pdf

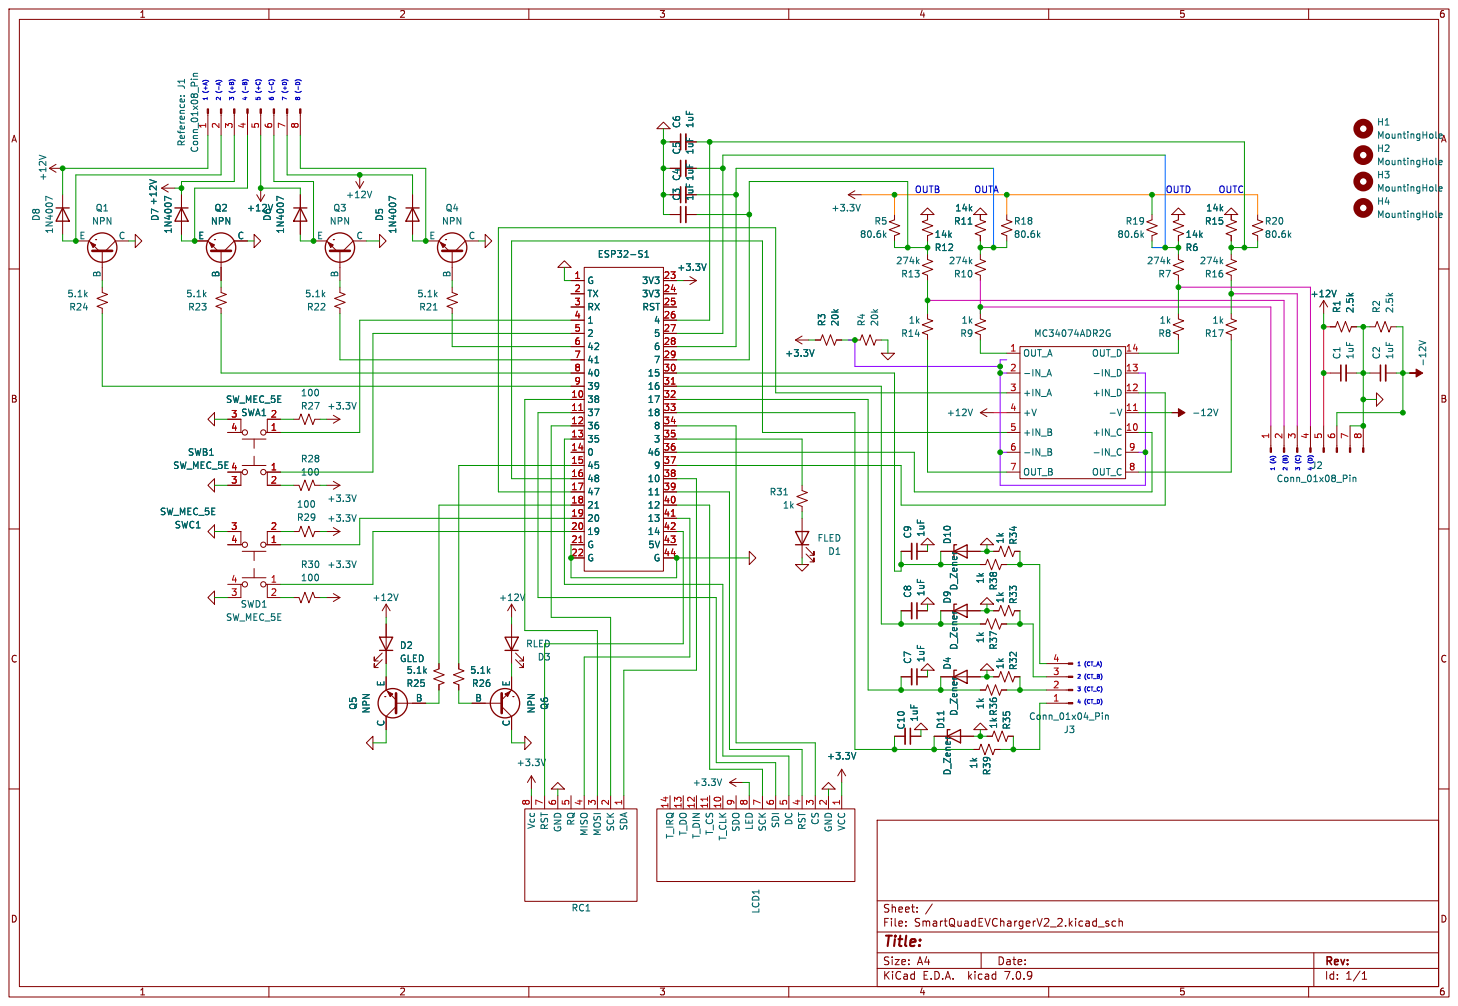
[picture p2: page 1]

Id: 1/1 Title: File: SmartQuadEVChargerV2_2.kicad_sch Sheet: /
