glazet/QuadEVCharger/Schematics/SmartQuadEVChargerV2_1.pdf

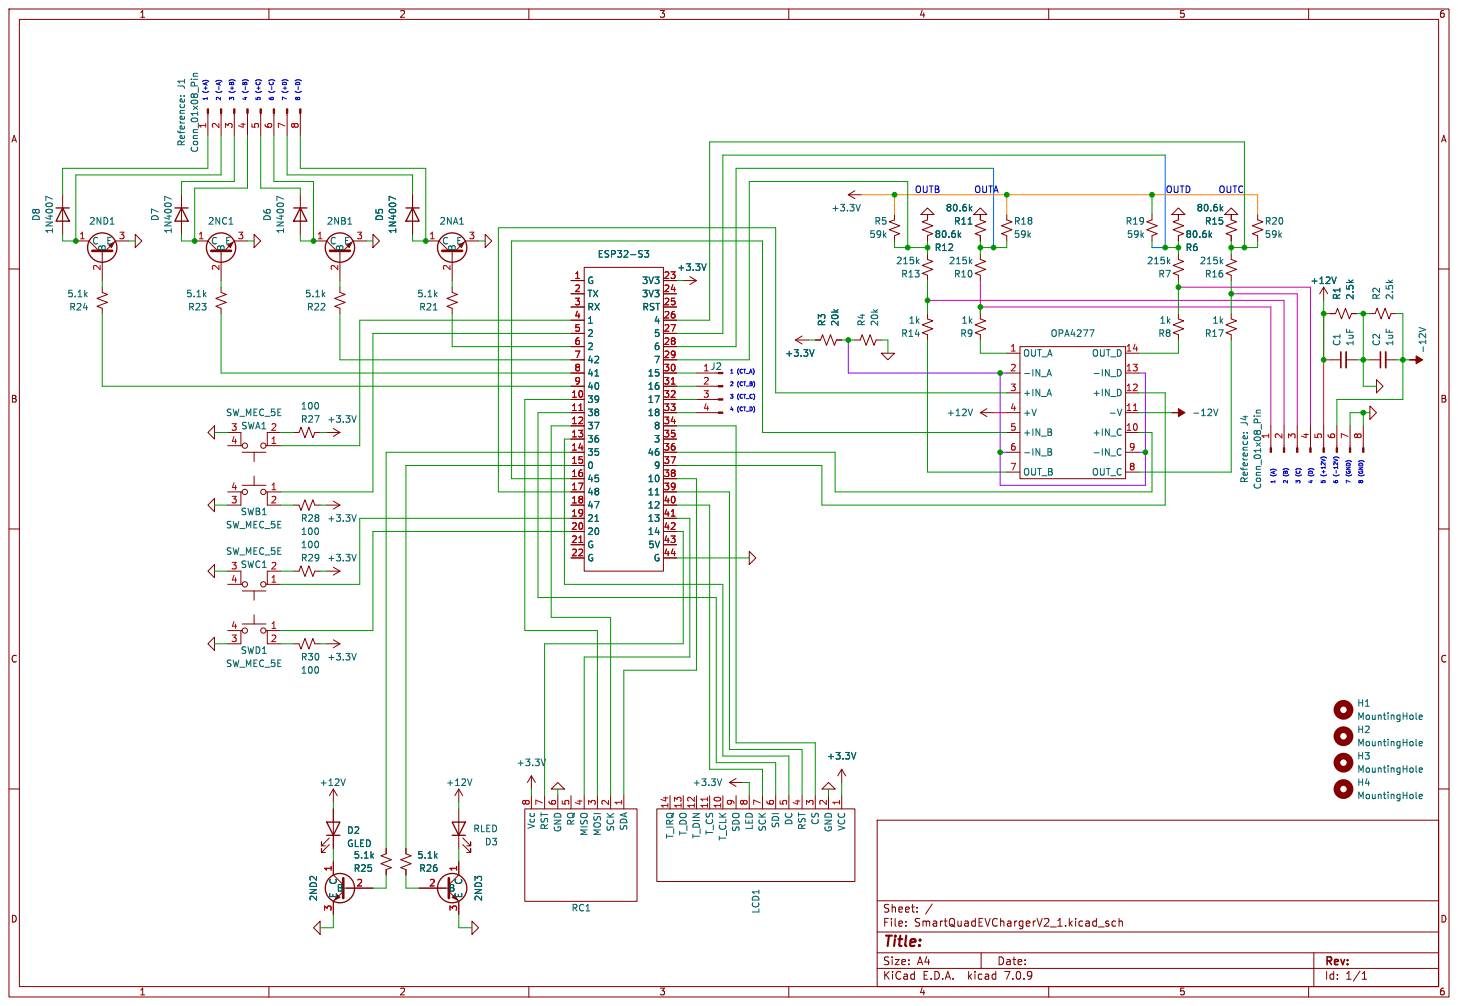
[picture p3: page 1]

1 (A) 2 (B) 3 (C) 4 (D) 5 (+12V) 6 (-12V) 7 (GND) 8 (GND) OUTA OUTD

Id: 1/1 Title: File: SmartQuadEVChargerV2_1.kicad_sch Sheet: /
