glazet/QuadEVCharger/Schematics/SmartQuadEVChargerV1.pdf

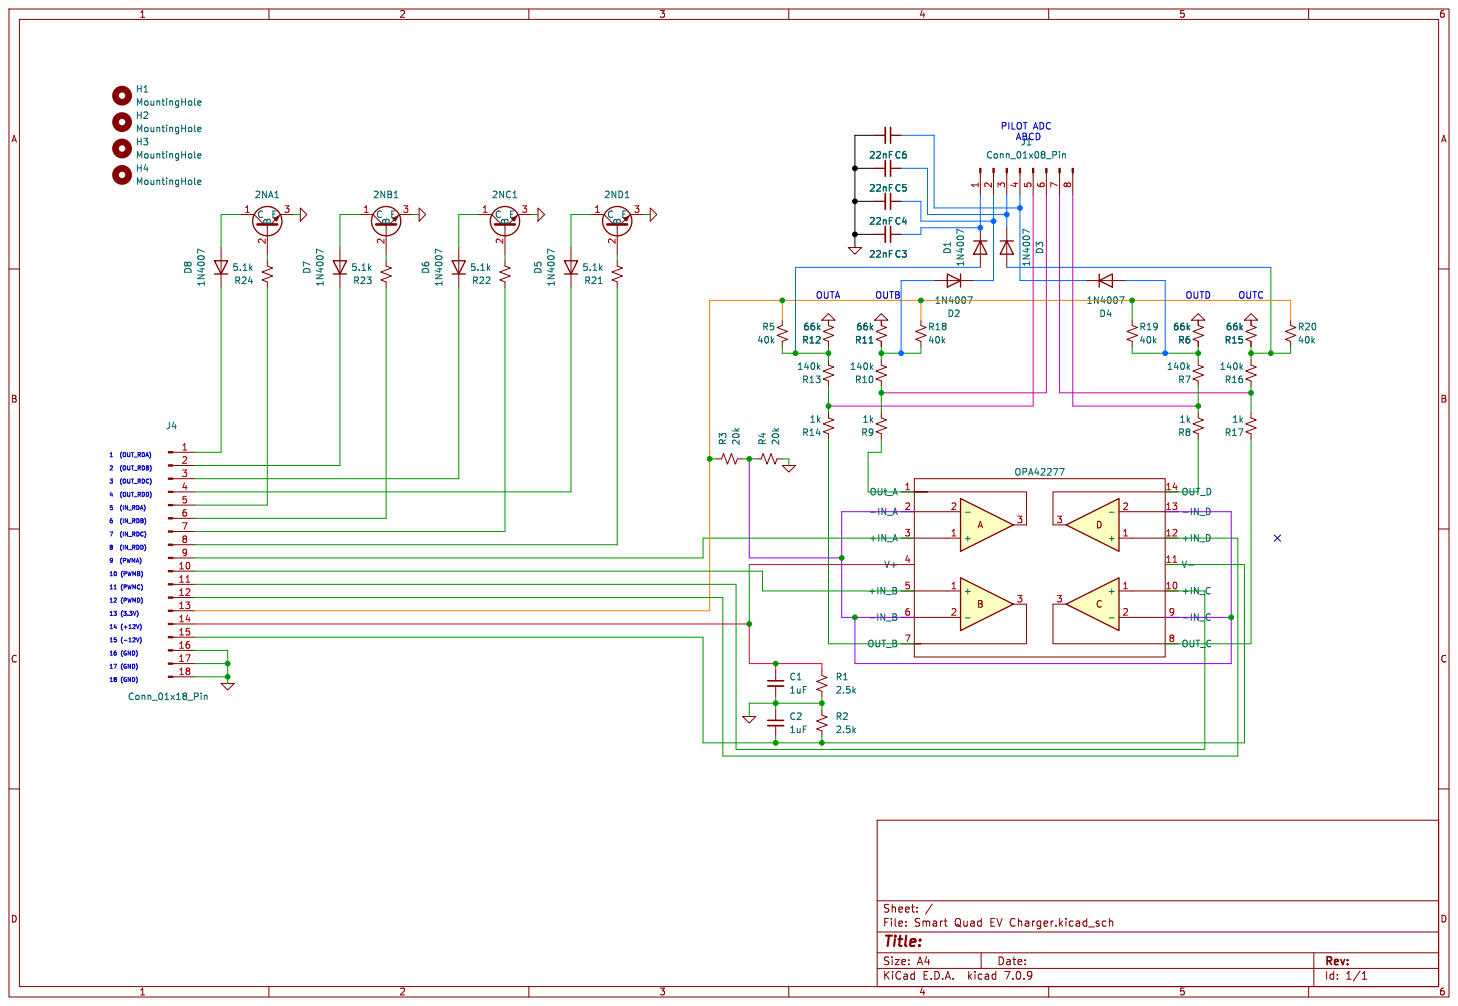
[picture p4: page 1]
