glazet/QuadEVCharger/Code/GUI/SQEC_GUI_V2_S3port.ino

#include <TFT_eSPI.h>
#include <WiFi.h>
#include <NTPClient.h>
#include <WiFiUdp.h>

TFT_eSPI tft = TFT_eSPI();  // Initialize the TFT display

// Define button coordinates and dimensions
#define BUTTON_WIDTH 67
#define BUTTON_HEIGHT 40
#define BUTTON_MARGIN 10

// WiFi credentials
const char *ssid = "placeholder"; // 
const char *password = "placeholder"; // 

// NTP Client
WiFiUDP ntpUDP;
NTPClient timeClient(ntpUDP, "pool.ntp.org");

int currentPage = 0;  // Current page index
bool wifiConnected = false;  // Flag to track WiFi connection state
unsigned long wifiStartTime;  // Time when WiFi connection attempt started

// Define button pins
int button1 = 4;
int button2 = 5;
int button3 = 13;
int button4 = 14;

// Define LED pins
int led1 = 46;  
int led2 = 9; 

void drawButton(int x, int y, const char *label, bool highlighted);
void drawWelcomePage();
void drawCardScannedScreen();
void drawPlugStatusScreen(int plugNumber);
void drawNonFunctioningScreen();

void setup() {
  Serial.begin(115200);

  tft.init();  // Initialize the TFT display
  tft.setRotation(1);  // Set rotation for landscape mode
  tft.fillScreen(TFT_BLUE);  // Set the background color to blue

  // Display "Welcome EV Owner!" title in the center
  tft.setTextColor(TFT_WHITE);  // Set text color to white
  tft.setTextSize(3);  // Set text size
  tft.setTextDatum(MC_DATUM);  // Center align text
  tft.drawString("Welcome EV Owner!", tft.width() / 2, tft.height() / 2);

  // Draw buttons at the bottom
  drawButton(10, 190, "Plug 1", currentPage == 0);
  drawButton(87, 190, "Plug 2", currentPage == 1);
  drawButton(163, 190, "Plug 3", currentPage == 2);
  drawButton(240, 190, "Plug 4", currentPage == 3);

  // Connect to WiFi
  WiFi.begin(ssid, password);
  wifiStartTime = millis();  // Record the start time of WiFi connection attempt

  while (WiFi.status() != WL_CONNECTED && millis() - wifiStartTime < 30000) {
    delay(1000);
    Serial.println("Connecting to WiFi...");
  }

  if (WiFi.status() == WL_CONNECTED) {
    Serial.println("Connected to WiFi");
    wifiConnected = true;
  } else {
    Serial.println("Failed to connect to WiFi within 30 seconds");
    drawNonFunctioningScreen();
  }

  // Display "WiFi Connected" in the top left corner on the welcome page
  tft.setTextColor(TFT_WHITE);
  tft.setTextSize(1);
  tft.setTextDatum(TL_DATUM);  // Top left align text
  tft.drawString("WiFi Connected", 10, 10);

  // Start NTP
  timeClient.begin();
  timeClient.setTimeOffset(-8 * 3600); // Set time zone offset to UTC-8 (Pacific Time)

  // Initialize button pins
  pinMode(button1, INPUT);
  pinMode(button2, INPUT);
  pinMode(button3, INPUT);
  pinMode(button4, INPUT);

  pinMode(led1, OUTPUT);
  pinMode(led2, OUTPUT);

  digitalWrite(led1, HIGH);
  digitalWrite(led2, HIGH);
  delay(200);
  digitalWrite(led1, LOW);
  digitalWrite(led2, LOW);
}

void loop() {
  // Update time
  timeClient.update();
  String currentTime = timeClient.getFormattedTime();
  
  // Extract hours and minutes
  int index = currentTime.indexOf(":");
  String hoursMinutes = currentTime.substring(0, index + 6);

  // Display hours and minutes in the top right corner
  tft.setTextColor(TFT_BLUE);  // Set text color to background color
  tft.setTextSize(2);
  tft.setTextDatum(TR_DATUM);  // Top right align text
  
  // Clear the area where the previous time was displayed
  delay(500);
  tft.fillRect(tft.width() - 125, 0, 250, 40, TFT_BLUE);

  // Display the new time
  tft.setTextColor(TFT_WHITE);  // Set text color to white
  tft.drawString(hoursMinutes, tft.width() - 10, 10);

  // Check button states and switch pages accordingly
  if (digitalRead(button1) == LOW) {
    currentPage = 1;
  } else if (digitalRead(button2) == LOW) {
    currentPage = 2;
  } else if (digitalRead(button3) == LOW) {
    currentPage = 3;
  } else if (digitalRead(button4) == LOW) {
    currentPage = 4;
  } else {
    currentPage = 0;
  }

  // Draw the appropriate page based on the current index
  switch (currentPage) {
    case 0:
      // Only draw the welcome page if WiFi state changes
      if (!wifiConnected) {
        drawWelcomePage();
        wifiConnected = true;
      }
      break;
    case 1:
      drawPlugStatusScreen(1);
      break;
    case 2:
      drawPlugStatusScreen(2);
      break;
    case 3:
      drawPlugStatusScreen(3);
      break;
    case 4:
      drawCardScannedScreen();
      break;
  }
}

void drawButton(int x, int y, const char *label, bool highlighted) {
  if (highlighted) {
    // Draw highlighting box
    tft.drawRect(x, y, BUTTON_WIDTH, BUTTON_HEIGHT, TFT_WHITE);
  } else {
    // Clear the highlighting box
    tft.fillRect(x, y, BUTTON_WIDTH, BUTTON_HEIGHT, TFT_BLUE);
  }

  // Draw button border
  tft.drawRect(x + 1, y + 1, BUTTON_WIDTH - 2, BUTTON_HEIGHT - 2, TFT_WHITE);
  
  // Draw button background
  tft.fillRect(x + 2, y + 2, BUTTON_WIDTH - 4, BUTTON_HEIGHT - 4, TFT_NAVY);

  // Draw button label
  tft.setTextColor(TFT_WHITE);  // Set text color to white
  tft.setTextSize(1);  // Set text size
  tft.setTextDatum(MC_DATUM);  // Center align text
  tft.drawString(label, x + BUTTON_WIDTH / 2, y + BUTTON_HEIGHT / 2);
}

void drawWelcomePage() {
  // Code to draw the welcome page
  tft.fillScreen(TFT_BLUE);  // Set the background color to blue

  if (WiFi.status() == WL_CONNECTED) {
    // Display "WiFi Connected" in the top left corner
    tft.setTextColor(TFT_WHITE);
    tft.setTextSize(1);
    tft.setTextDatum(TL_DATUM);  // Top left align text
    tft.drawString("WiFi Connected", 10, 10);
  }
  
  // Display "Welcome EV Owner!" title in the center
  tft.setTextColor(TFT_WHITE);  // Set text color to white
  tft.setTextSize(3);  // Set text size
  tft.setTextDatum(MC_DATUM);  // Center align text
  tft.drawString("Welcome EV Owner!", tft.width() / 2, tft.height() / 2);

  // Draw buttons at the bottom
  drawButton(10, 190, "Plug 1", currentPage == 0);
  drawButton(87, 190, "Plug 2", currentPage == 1);
  drawButton(163, 190, "Plug 3", currentPage == 2);
  drawButton(240, 190, "Plug 4", currentPage == 3);
}

void drawCardScannedScreen() {
  // Code to draw the screen that says the card has been scanned
  tft.fillScreen(TFT_BLUE);  // Set the background color to black
  tft.setTextColor(TFT_WHITE);  // Set text color to white
  tft.setTextSize(2);  // Set text size
  tft.setTextDatum(MC_DATUM);  // Center align text
  tft.drawString("Card Scanned! Thank You!", tft.width() / 2, tft.height() / 2);
  digitalWrite(led1, HIGH);
  delay(750);
  digitalWrite(led1, LOW);
  delay(750);
  digitalWrite(led2, HIGH);
  delay(750);
  digitalWrite(led2, LOW);
  delay(750);
  drawWelcomePage();
}

void drawPlugStatusScreen(int plugNumber) {
  // Code to draw the screen displaying the status of a plug
  tft.fillScreen(TFT_BLUE);  // Set the background color to green
  tft.setTextColor(TFT_WHITE);  // Set text color to black
  tft.setTextSize(2);  // Set text size
  tft.setTextDatum(MC_DATUM);  // Center align text
  tft.drawString("Plug " + String(plugNumber) + " Status:", tft.width() / 2, tft.height() / 2);
  tft.drawString("Energy (kWh):", 150, 170);
  tft.drawString("Elapsed Time:", 150, 195);
  drawChargingAnimation();
  delay(500);
  drawWelcomePage();
}

void drawNonFunctioningScreen() {
  // Code to draw the non-functioning screen
  tft.fillScreen(TFT_RED);  // Set the background color to red
  tft.setTextColor(TFT_WHITE);  // Set text color to white
  tft.setTextSize(2);  // Set text size
  tft.setTextDatum(MC_DATUM);  // Center align text
  tft.drawString("OUT OF ORDER!", tft.width() / 2, tft.height() / 2);
  digitalWrite(led2, HIGH);
  delay(750);
  digitalWrite(led2, LOW);
  delay(750);
  digitalWrite(led2, HIGH);
  delay(750);
  digitalWrite(led2, LOW);
  delay(750);
  digitalWrite(led2, HIGH);
  delay(750);
  digitalWrite(led2, LOW);
  if (WiFi.status() == WL_CONNECTED) {
    Serial.println("Connected to WiFi");
    drawWelcomePage();
  } else {
    Serial.println("Failed to connect to WiFi");
    drawNonFunctioningScreen();
  }
}

void drawChargingAnimation() {
  // Initialize the start time for the charging animation
  unsigned long startTime = millis();
  unsigned long animationDuration = 10000;  // 10 seconds
  
  int loadOutlineX = 75;
  int loadOutlineY = 140;
  int loadOutlineWidth = 165;
  int loadOutlineHeight = 15;
  int loadFillWidth = 0;
  int loadFillHeight = 15;
  int loadIncrement = 3;  // Adjust the increment to control the speed of the animation

  // Continuously update the charging animation for 5 seconds
  while (millis() - startTime < animationDuration) {
    // Draw the outline of the loading bar
    tft.drawRect(loadOutlineX, loadOutlineY, loadOutlineWidth, loadOutlineHeight, TFT_WHITE);
    
    // Draw the filled portion of the loading bar
    tft.fillRect(loadOutlineX, loadOutlineY, loadFillWidth, loadFillHeight, TFT_WHITE);
    
    // Increment the width of the filled portion
    loadFillWidth += loadIncrement;

    // If the bar is completely filled, reset it
    if (loadFillWidth >= loadOutlineWidth) {
      loadFillWidth = 0;
      tft.fillRect(loadOutlineX, loadOutlineY, loadOutlineWidth, loadOutlineHeight, TFT_BLUE);
    }

    delay(100);
  }
}
