glazet/QuadEVCharger/(commit log)

2024-02-24 Create Current Transformer ADC Code
2024-02-24 Add files via upload
    Added Relay Driver Circuit, LEDs, LCD, NFC Reader, and Push Buttons
2024-03-02 Update NFCESPReader.ino
    Updated pin numbers. Added a while loop if card is not read within 10 seconds it produces a false indicating an error or no card read. If card has been read the function will produce a true and set the variable tagID to the tag's ID.
    [NFCESPReader.ino]
2024-03-03 Update NFCESPReader.ino
    Updated pin numbers. Fixed not compiling issue.
    [NFCESPReader.ino]
2024-03-04 Add files via upload
    Updated pin numbers on ESP32-S3, control pilot resistor values based on Neil's recommendation and removed resistors for LEDS since they have internal resistors.
2024-03-07 Update WorkingNFCGUI.ino
    Added Comments, several functions, welcomescreen, drawbutton, tapcardscreen, fillscreenblank, checkbuttonpress, onled, offled, startup, iswifiup.
    Able to display startup screen, checks if it is connected to wifi if it is not send and error message and light up red led. If it is connected proceed to welcome screen. Clicking one of the plug buttons promts the user to tap their card.
2024-03-10 Update SQEVMain.ino
    Added charging algorithm
2024-03-26 Update SQEVMain.ino
    Working Priority,
    Bugs:
    Priority list is not formatted correctly.
    Fan led does not turn on at voltage range.
    Status screen counts up instead of down.
    Need to add:
    Charging Status screen
    [SQEVMain.ino]
2024-04-02 Update SQEVMain.ino
    Added comments, fixed pilotRead function, and fixed plugStat
    [SQEVMain.ino]
2024-04-08 Rename Current Transformer ADC Code.txt to Current Transformer ADC Codee.ino
